yidayy/CAN-Python/(commit log)

2026-10-26 chore: 工程骨架（CubeMX + CMake 构建配置）
2026-10-26 chore: STM32CubeF1 HAL 驱动（按 .ioc 裁剪子集）
2026-10-26 feat(firmware): CAN 双轴伺服固件（20kHz PWM/OLED/USART 遥测/CAN 协议栈）
2026-10-26 feat(tools): PC 上位机 can_host.py（python-can，协议对齐 can_proto.h，含 selftest）
2026-10-26 docs: README 补 CAN/上位机章节，附真机遥测曲线
2026-10-26 docs: README 重写为第一人称项目讲解
2026-10-26 docs: README 标题改为 CAN-Python 项目讲解
